shimniok/eeZeeBigTiny/documentation/images/assembly6.jpg

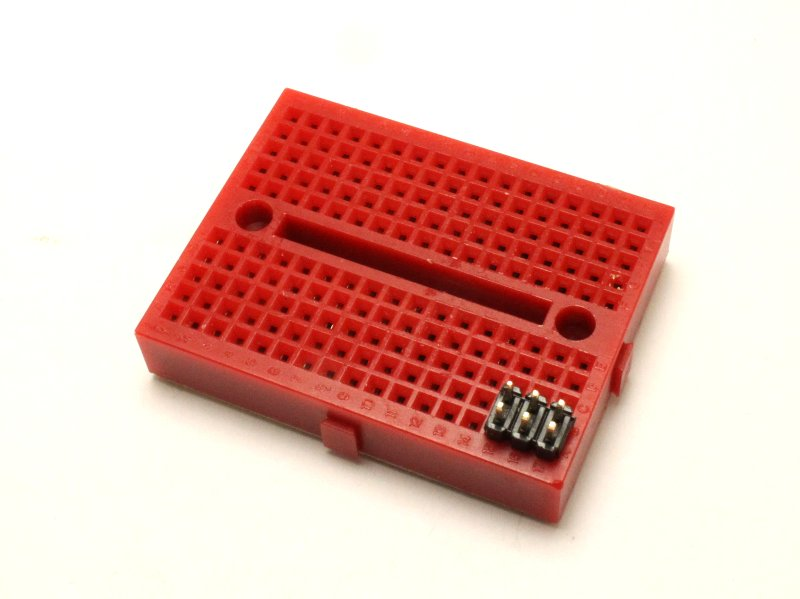
documentation/images/assembly6.jpg
