shimniok/eeZeeBigTiny/documentation/images/assembly2.jpg

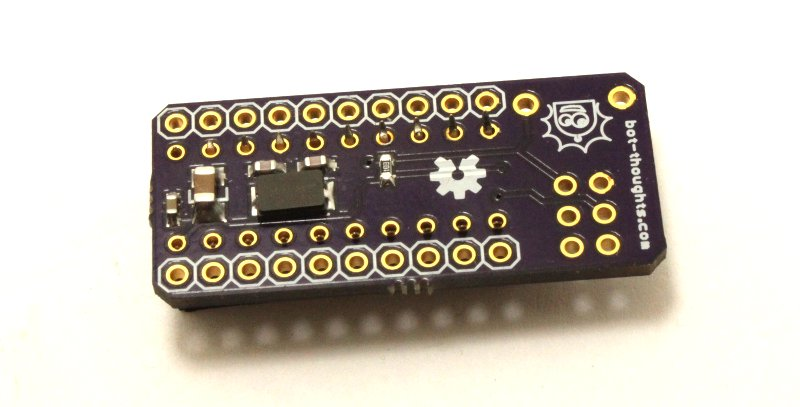
documentation/images/assembly2.jpg
