shimniok/eeZeeBigTiny/electronics/eeZee_big_tiny.brd

## EAGLE design electronics/eeZee_big_tiny.brd (2014-10-17)

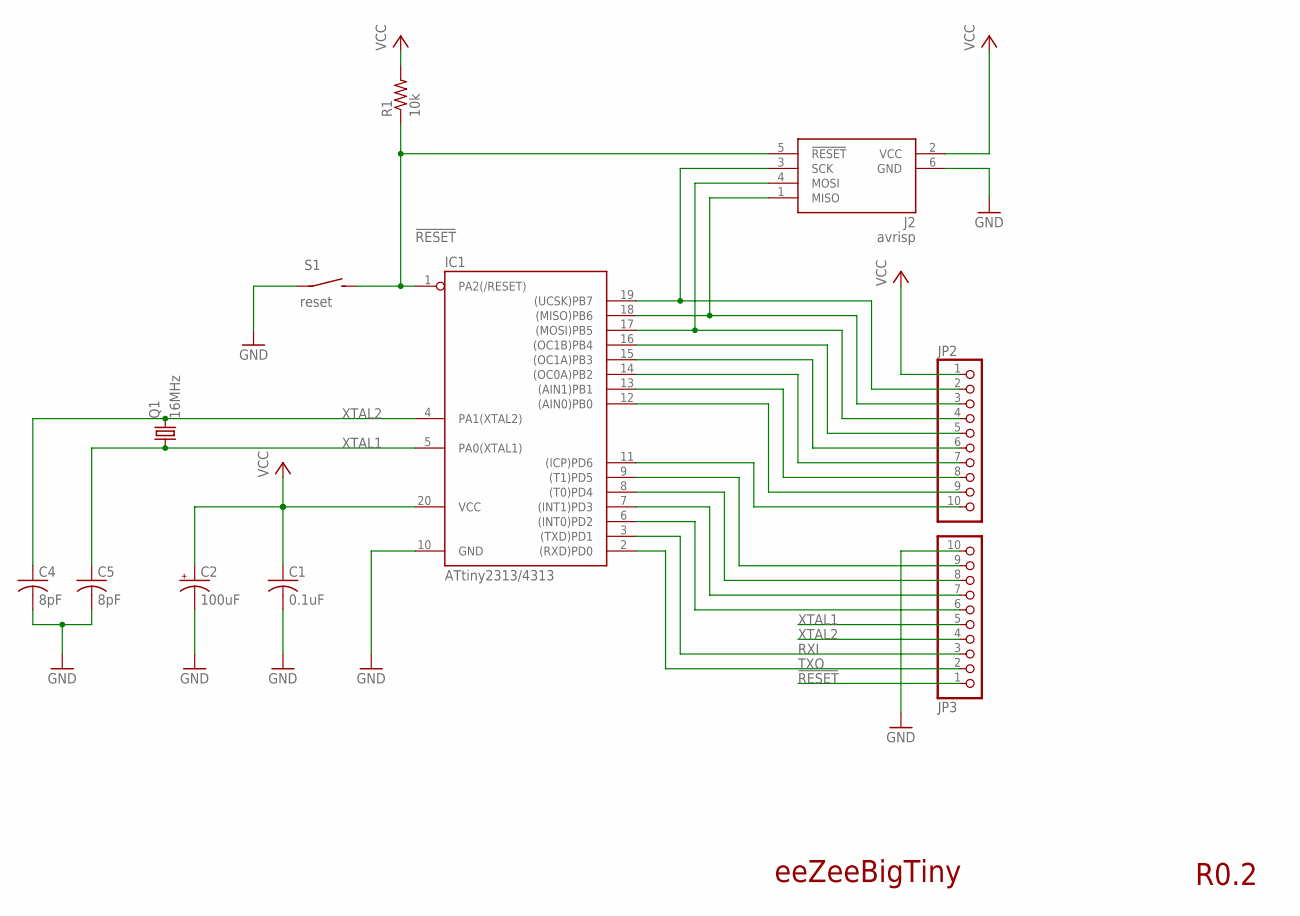
[picture p3: schematic eeZee_big_tiny.sch]

Parts:
C1: 0.1uF; C0603; PARTNO 0603YC104KAT2A
C2: 100uF; SMC_B; PARTNO MCTT21X106M6R3CT
C4, C5: 8pF; C0603; PARTNO 0603YC104KAT2A
IC1: ATtiny2313/4313; DIL20
J2: avrisp; CON6P2R
JP2, JP3: PINHD-1X10_2.54-S; 1X10-S
Q1: 16MHz; NDK_2PAD_5X3
R1: 10k; R0603; PARTNO ERJ-3GEYJ103V
S1: reset; 6MMTACTILE_RECT

Connections:
!RESET: IC1.1 (PA2(/RESET)), J2.5 (!RESET), JP3.1, R1.1, S1.P$2 (S)
GND: C1.2, C2.-, C4.2, C5.2, IC1.10 (GND), J2.6 (GND), JP3.10, S1.P$1
unnamed: IC1.18 ((MISO)PB6), J2.1 (MISO), JP2.3
unnamed: IC1.17 ((MOSI)PB5), J2.4 (MOSI), JP2.4
unnamed: IC1.19 ((UCSK)PB7), J2.3 (SCK), JP2.2
unnamed: IC1.6 ((INT0)PD2), JP3.6
unnamed: IC1.7 ((INT1)PD3), JP3.7
unnamed: IC1.8 ((T0)PD4), JP3.8
unnamed: IC1.9 ((T1)PD5), JP3.9
unnamed: IC1.11 ((ICP)PD6), JP2.10
unnamed: IC1.12 ((AIN0)PB0), JP2.9
unnamed: IC1.13 ((AIN1)PB1), JP2.8
unnamed: IC1.14 ((OC0A)PB2), JP2.7
unnamed: IC1.15 ((OC1A)PB3), JP2.6
unnamed: IC1.16 ((OC1B)PB4), JP2.5
RXI: IC1.3 ((TXD)PD1), JP3.3
TXO: IC1.2 ((RXD)PD0), JP3.2
VCC: C1.1, C2.+, IC1.20 (VCC), J2.2 (VCC), JP2.1, R1.2
XTAL1: C5.1, IC1.5 (PA0(XTAL1)), JP3.5, Q1.P$1 (1)
XTAL2: C4.1, IC1.4 (PA1(XTAL2)), JP3.4, Q1.P$2 (2)

Notes on the sheet:
eeZeeBigTiny
R0.2

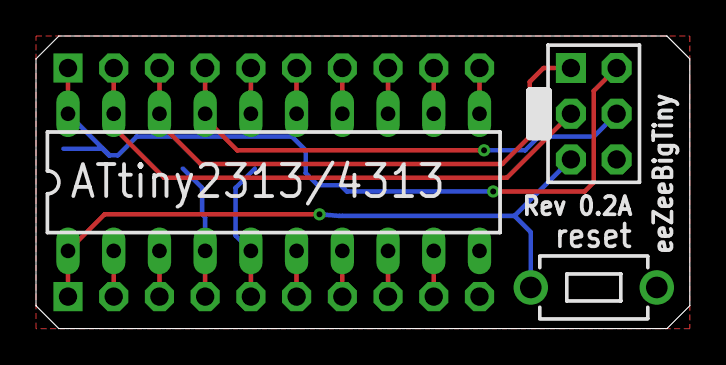
[picture p4: board eeZee_big_tiny.brd from above]

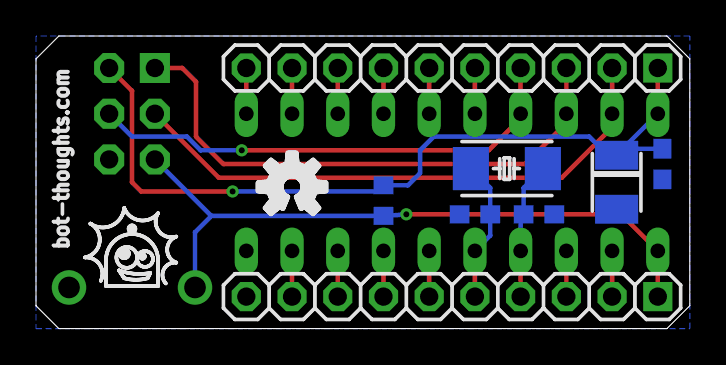
[picture p5: board eeZee_big_tiny.brd from below]

Board: 2 copper layers, 36.3 x 16.3 mm, 11 parts (8 on the bottom side), 20 nets.
