shimniok/eeZeeBigTiny/(commit log)

2013-01-02 eeZee 14-pin ATtiny breakout
    [eeZee_big_tiny.brd, eeZee_big_tiny.sch]
2013-01-03 Tweaks to big cap, routing
    [eeZee_big_tiny.brd, eeZee_big_tiny.sch]
2013-01-04 Added crystal+caps
    [eeZee_big_tiny.brd, eeZee_big_tiny.sch]
2013-01-30 Removed FTDI header, revised layout to reduce leading edge clearance on breadboard.
    [eeZee_big_tiny.brd, eeZee_big_tiny.sch]
2013-02-26 Revised board layout to match the new Tiny style, swapping in new reset button
    [eeZee_big_tiny.brd, eeZee_big_tiny.sch]
2013-08-06 Rev 0.2, mitered corners, changed silk on tantalum to indicate polarity, few minor rearrangements.
    [eeZee_big_tiny.brd, eeZee_big_tiny.sch]
2013-08-06 Adding gerbers
    [eeZee_big_tiny.drills.xln]
2013-11-10 Moving electronics files into subdir so i can also have example software
    [eeZee_big_tiny.brd, eeZee_big_tiny.sch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]
2014-10-17 Changed spaces to 10mil/8mil, relocated trace
    [eeZee_big_tiny.brd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]
2015-10-19 Added assembly instructions
2015-10-19 Update README.md
    Added link to assembly instructions and bot thoughts store on Tindie.
2017-04-29 modified to light up pins in correct order
    [main.c]
2021-02-10 Added images, added more filters to .gitignore
